sinara-hw/zapper/README.md

# Zapper
EEM with high-voltage source/PZT driver

## Design Files

Design files (schematics, PCB layouts, BOMs) can be found at [Zapper/Releases](https://github.com/sinara-hw/Zapper/releases).

## Wiki

More information can be found on the [wiki](https://github.com/sinara-hw/Zapper/wiki).
