sinara-hw/zapper/(list of files, drawings)

Other design files:
PCB/DAC_8CH.SchDoc
PCB/Filter.SchDoc
PCB/LVDS.SchDoc
PCB/OutputChannel.SchDoc
PCB/PowerSupp.SchDoc
PCB/SCHMITT_LED.SchDoc
PCB/Zapper.PrjPcb
PCB/Zapper.SchDoc
