sinara-hw/zapper/(threads)

Thread 1 (2019-02-06):

[RFC] new EEM: zapper (high-voltage source/PZT driver)

dtcallcock, 2019-02-06:
High voltage supplies are commonly required in ion trap experiments.  These are widely commercially available but typical models have many of the following drawbacks:

- Noisy output
- Radiated RFI from the box
- Expensive
- Poor stability
- Low channel density
- High power dissipation when voltage output static
- Unnecessarily high current capability (safety issue as well as being the root cause of most of the above)
- Flaky USB connection with high latency

# Use cases

### Trap electrode voltages

Zotino only provides ±10V.  This is generally fine for small high-electrode-density surface traps.  However many groups operate larger surface traps or macroscoptic traps of the 'blade' or 'wafer' variety.  These typically need much higher voltages, from a few 10s of Volts up to a few hundred Volts.  Requirements are basically the same as for Zotino but scaled to higher voltages.  The [thesis](https://www2.physics.ox.ac.uk/sites/default/files/2011-08-15/cjbthesisfinal_pdf_33239.pdf) of Chris Ballance has a good discussion of the requirements and a circuit design that could be the basis of this EEM.  This type of trap generally has less electrodes so a <32-ch solution may be acceptable.

### Slow piezos

We have several piezo-actuated mirrors on our experiment, such as the Thorlabs [Polaris K1S2P](https://www.thorlabs.com/newgrouppage9.cfm?objectgroup_ID=5035).  These need 0-150V and have a 0.35uF of capacitance.  The Thorlabs [MDT694B/MDT693B](https://www.thorlabs.com/newgrouppage9.cfm?objectgroup_id=1191) are ubiquitous in our lab but suffer many of the problems described above.  For this use case, the new [PiezoDrivePD32](https://www.piezodrive.com/product/pd32-multi-channel-piezo-driver/) may be a good commercial alternative when coupled with a Zotino.  I haven't tested one out but we have been happy with other products from PiezoDrive.

# Implementation

### DAC

16-bit resolution.

A few options:

- Use Zotino.  The card would sit next to Zotino and be connected to the IDC headers on it via a ribbon cable(s).  Lower risk, less development work, and the Artiq driver would be pretty much for free.  Frees up board real estate as no EEM connector etc. would be needed.

- Use an onboard DAC.  The 32-ch AD5372 in Zotino has 8-ch ([AD5362](http://www.analog.com/en/products/ad5362.html)) and 16-ch ([AD5360](http://www.analog.com/en/products/ad5360.html)) equivalents if that is likely to reduce risk/effort.  At 4-ch and 8-ch, more accurite, lower noise DACs are available.

### Channel Count

This will probably depend a lot on the power consumption, size, and cost of the output stage we decide on.  8 would be a reasonable starting point.

### Ranges

Traps generally require a mix of high positive voltages for endcaps (becasue our ions are positively charged) and lower bipolar voltages for other electrodes.  There seems to be 2 options for dealing with this:

- Per board range selection.  The board could be configured as either single ended or bipolar.  If different ranges are required, you just use two boards.  The cheaper the board is and the lower the number of the channels, the less of an issue this is.

- Per channel range selection.  Board has three supply rails (+V1, +V2 and -V2).  Each channel can be changed to run at 0 to +V1 or -V2 to V2 using jumpers or component selection.

### Voltages

It would be good to hear from potential users here.  As a starting point, how about:

0 to +V1 or -V2 to +V2 where V1= 200, 100, or 50V and V2 = 100, 50 or 25V

Historically some traps have used >1kV but my guess is that there isn't a sensible design that covers that and 10s of volts.

### Bandwidth

Zotino has 75kHz analog bandwidth.  This sounds like a reasonable starting point.

There should be the option to install components that drastically limit this to say, 100s of Hz.

### Stability

Zotino output stage has "Worst-case OpAmp self-heating is about 25C. At 0.2ppm/C, this is 4ppm, which is fine!"  This might be harder to achieve at high voltages but <10ppm would be nice.

### Connectors

- Individual Front Panel coax connectors - Often slightly less common connectors are used on HV supplies to prevent accidentaly connecting the wrong thing and destroying it.  I have seen SMB, SMC, LEMO OO and LEMO 0B used.

- High Density Connector - D-sub etc.

- Both - Same idea as Zotino, where the high density connector can be installed or a ribbon cable run to a panel with individual connectors on it (ie. a [BNC-IDC](https://github.com/sinara-hw/BNC_IDC/)).  We could make a version of BNC-IDC with SMB etc. instead.

hartytp, 2019-02-06:
Neat. What's the plan? Will you use a potted module? HV OpAmps? Or discrete components? Will it be something like the JQI design?

gkasprow, 2019-02-06:
Let's try to build a discrete amplifier circuit. HV power supply could be COTS component.

hartytp, 2019-02-06:
Cool, it's a fair bit of work that way, but if you get it right the performance is really good. Also, more fun :)

IIRC, the JQI design is based from a laser printer IC which provides the HV supply. Then they add a linear circuit to do post regulation. I think that's probably the best way to go.

gkasprow, 2019-02-06:
do you mean [this](http://sci-hub.tw/10.1063/1.4969059) design?

hartytp, 2019-02-06:
That's the one. I've never used it, but it seems nice. Probably worth asking @npisenti for his views on what they like/dislike about the circuit and any ideas they have for improvements.

A few channels of something like that on an EEM would be ace. Maybe PoE?

There are a few design decision you need to make like modulation sources (analog? digital? EEM?) bandwidth etc.

hartytp, 2019-02-06:
For the post regulator, might also being worth checking out the design that @cjbe posted a while ago.

IIRC there are (as always) some nice designs for this in the Hobbs book (and I remember seeing some designs for comically low noise PZT drivers in various places he lurks on the internet).

JakeBlackmore, 2019-03-18:
Hello,
I was directed here by a colleague using ARTIQ. Is there scope for a version of this design which works up to +/- 5 kV?

gkasprow, 2019-03-18:
The specification is not yet fully defined. What BW and slew rate do you need? What load capacitance? What did you use before?

gkasprow, 2019-05-31:
I have an application where a lot of channels is needed, 8 or even 16 per module, +/- 150V at least with reference to GND and ultra-low noise, a few uV pp. Bandwidth is not that critical, a few kHz does the job. Load capacitance is not critical, I will have tens of pF.
Such a driver could be based on Zotino to keep the SW compatibility to some extent.
Can we compile the final specification for my student which also includes specification above?

hartytp, 2019-05-31:
> Such a driver could be based on Zotino to keep the SW compatibility to some extent.

I'm fine with keeping the HV amp and DACs on separate boards if you prefer. However, FWIW, my feeling is that having fewer boards in the stackup is always better. It's trivial to add a multi-channel DAC + filters to your HV amb board, so not much time saved by using Zotino for this. (However, if you use a DAC in the same family as the Zotino DAC then you can reuse the same design and software, so it's just a copy-paste job).

gkasprow, 2019-05-31:
Oh, I meant modifying the Zotino design :)
I want to have a single multi-channel board that has HV, DAC, and drivers on the same PCB.
Would the Zotino DAC speed be enough for your application? Or it would be better to rather switch to Fastino type DACs?

hartytp, 2019-05-31:
> Oh, I meant modifying the Zotino design :)

Aah, glad we agree :)

> Or it would be better to rather switch to Fastino type DACs?

That would be nice as it allows things like locking cavities at a decent bandwidth. The downside is that doing that with a decent number of channels makes the digital interface more complex (misoc/artiq doesn't support QSPI right now).

gkasprow, 2019-05-31:
well, we can make the SPI interface first, then upgrade the FPGA. The same we will probably do for Fastino.

gkasprow, 2019-06-01:
What about the following spec:
- channel count: 8
-  low [cost Apex amplifiers](https://www.digikey.com/products/en/integrated-circuits-ics/linear-amplifiers-instrumentation-op-amps-buffer-amps/687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), PA341DF would be rpobably fine
- 8 channel AD5362
- at each output we can install active AC-coupled noice cancellation circuit that can be disabled by software when high speed operation is required. We can use OPTOMOS relays to diasable it.
- operating voltage could be controlled by DIP switches. Negative -50, -100, -200, positive +50, +100, +200 with limitation of 350V with HW protection against opamp damage. DAC references would need to be adjusted as well.
- COTS DC/DC converters
- what about the offset cancellation ADC?
- EEM interface. It can be always controlled by Stabilizer EEM and supplied by its PoE.
- DSUB connector + on-board IDC connector for BNC breakout.

gkasprow, 2019-06-01:
By noise cancellation circuit I meant [this](https://github.com/JQIamo/hv-piezo-driver/blob/master/Eurocard-HV-piezo-driver_Schematic_v1.2.pdf) approach

gkasprow, 2019-06-01:
Two such [DC/DC](https://recom-power.com/pdf/Innoline/Rxx-B.pdf) converters could do the job. They go down to 90V but could not find others that can be adjusted more than 90...200V

restelli, 2019-07-11:
> For everyone considering PDu150, the outputs are differential only, NOT single ended, and you cannot ground-reference one output. Thus it won't work for typical piezo actuators where the signal is ground-referenced on one lead.

Neil Pisenti and I a few years ago designed a ground-referenced low noise piezo driver for the JQI strontium lab based of the [DRV2700](http://www.ti.com/product/DRV2700). Despite the DRV2700 being quite noisy by itself we were able to suppress its ripple and obtain noise levels comparable with the best commercial controllers. Noise characterization and overall design are available in our RSI paper: https://arxiv.org/abs/1609.03607

The project is on Github: https://github.com/JQIamo/hv-piezo-driver

The main limitations of the design is that the control bandwidth is limited for large amplitude signals.

sbourdeauducq, 2019-08-07:
If we have a lot of bandwidth (1MHz or more), then this circuit can also be useful with EOMs (e.g. https://www.thorlabs.com/newgrouppage9.cfm?objectgroup_id=2729) for laser intensity stabilization.

dtcallcock, 2019-08-08:
Note that the standard drivers for these are +/- 200V, 100mA beasts.  If that's what you are after it may be incompatible with (my hope of) something that's higher channel density, lower noise, and lower power consumption than what's already out there.

sbourdeauducq, 2019-08-08:
200V*1MHz*14pF = 2.8mA. Are the standard drivers able to go much higher than 1MHz, is the 14pF specification inaccurate, or is there something else going on?

dtcallcock, 2019-08-08:
Don't forget that coax cable is some 10s of pF/ft.

Still, their driver does seem a bit over-specced.  Also somewhat overpriced at $2.6k...

jordens, 2019-08-08:
And there is a factor of 2*pi > 6 as well.

adamkolodynski, 2020-01-23:
Hello
I have a few questions about the design of this board.
1. Are onboard DAC required? Using Zotino would make it way simpler, and there is always a possibility to add e.g. fast DAC later, in another version.
2. What power supply is available, except the EEM connector?

dtcallcock, 2020-01-23:
Hi #adamkolodynski

Are you developing the spec Greg laid out [above](https://github.com/sinara-hw/zapper/issues/1#issuecomment-497932589)?

If so:

> Are onboard DAC required? Using Zotino would make it way simpler

Sure, but Zotino is quite expensive.  Having to add a pricy 32ch card to use this card would be a bit annoying.  Using AD5362 (8ch version of AD5372 32ch DAC on Zotino) should allow a lot of Zotino design/code reuse.

> there is always a possibility to add e.g. fast DAC later, in another version.

If the analog BW is <100kHz, then the AD5362 should be able to pretty much saturate that.  There could also be an IDC input connector on the board and jumpers to disconnect the DAC to allow this.

> What power supply is available, except the EEM connector?

If it has DACs on it and power consumption is reasonable then I think just EEM is fine and in line with what's done elsewhere.

gkasprow, 2020-01-23:
About the power supply selection, look [here](https://github.com/sinara-hw/Stabilizer_Piezo_Driver/issues/4)

JakubKajzer, 2020-02-01:
Does anybody need a noise cancellation circuit in this module?

adamkolodynski, 2020-02-21:
After reading the thread about power supply I see some major issues.
Can we use ADHV4702 with -12V and +110V supply, or keep PA341DF?
Is +110V enough range in this use?
ADHV4702 has 20 mA output current, what load we have to drive if we still target 100 kHz?

sbourdeauducq, 2020-02-21:
PA341 is "No longer supported for design in" and no longer supplied by DigiKey.
FWIW I've also had a bad experience with an Apex part that was expensive and not performing so well; I would trust ADI more or even a design with discrete BJTs (not so hard to do IME and you can exceed the performance of commercial ICs - but BJTs with the right characteristics can be subject to sourcing problems as well).

gkasprow, 2020-02-22:
I'd give an option to adjust the positive HV value.
The negative would be -5V, the positive could be 105 or 205V. The IC requires 2V supply margin.
The power supplies need to have LC filter and LDOs at its outputs.

gkasprow, 2020-02-22:
Before you publish the entire schematic, please open separate issues with proposed parts of schematics like decoupling, DAC, supply, etc It will make the feedback faster.

adamkolodynski, 2020-03-31:
I started 2 new issues. First about DAC, and second about the power supply, and will probably add another about the output stage.

gkasprow, 2020-07-16:
can you please commit the current version of schematics?

adamkolodynski, 2020-07-20:
I have a few questions about connectors.
One I assume will be IDC to connect with this [IDC-BNC adapter](https://github.com/sinara-hw/BNC_IDC/wiki). I don't know the purpose of SCSI power pins(+-13V) here, should I left them floating?
The second will be standard D-SUB connector, and since we don't use differential output just reference to GND and low currents can we use 15 pins D-SUB with 8 signal pins and 7 GND or simply 25 pins D-SUB with 8/8 pins configuration and rest unconnected.
[Zapper.pdf](https://github.com/sinara-hw/zapper/files/4950283/Zapper.pdf)

gkasprow, 2020-07-20:
I wouldn't use the same connectors as Zotino. Sooner or later someone will mix the two and cause damage.
Just use the D-SUB connector. High-density D-SUBs may not like the 200V range. Just use standard 15pin D-sub. Maybe there are some standard cables available that could be used as they are? If so, it would be nice to follow their pinout...

adamkolodynski, 2020-08-07:
I found standard 15 pin D-sub cable and it belongs to GAMEPORT cable(obsolete standard for joystick). Is it worth following this pinout(picture below): signals to analog and digital pins, gnd to gnd and +5V?
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
About breakout to BNC from DA-15, is it required to create an adapter similar to existing [link](https://github.com/sinara-hw/BNC_IDC/wiki) ?

gkasprow, 2020-08-12:
VGA  have some lines shielded, some not, so it is not good idea.
The Gameports cables were attached to joysticks, I'm not sure if one can buy them.
I was thinking about DB15 serial cables like this [one ](https://www.amazon.com/Your-Cable-Store-10-DB15/dp/B002HYJS7I)

adamkolodynski, 2020-08-14:
I meant exactly cable like this, just I found it described as gameport to gameport, anyway they are hard to find, so I will leave pinout like it is now.
I made some minor changes(resistor tolerance, track width, etc.) to the first release. I already asked @gkasprow as my supervisor for a more complex check, but I would appreciate any feedback.

Thread 3 (2020-02-28):

Zapper - 8 channel DAC and EEM

adamkolodynski, 2020-02-28:
### DAC voltage range
I think the best output range would be 0 to+10 V, [DAC](https://www.analog.com/media/en/technical-documentation/data-sheets/AD5362_5363.pdf) has also configurable offset registers, but I don't know how convenient are their usage. The voltage range is defined by 4xVref, but we have to be in +-1.4 V from the power supply. I see two options:
-	Power supply -5 V/+12 V, Vref=2,5 V, but we need to use offset registers.
-	Power supply +-12 V, Vref =5 V, but we losing half of the span.

### DAC additional functions
Translating signal from EEM and DAC design are very similar to Zotino, but [AD5362](https://www.analog.com/media/en/technical-documentation/data-sheets/AD5362_5363.pdf) has more additional functions that AD5372, so I need to know which can be useful.
1. Packet Error Check Output - now connected to EEM connector, but if any more important use of this I/O appears probably will leave it.
2. Monitor - output could be connected to a gold pin(or another connector) and used for testing and monitoring.
3. Temperature sensor - might be useful later.
4. Programmable GPIO - will find some application later.

### Current schematic files

[LVDS schematic](https://github.com/sinara-hw/zapper/files/4266615/LVDS.pdf)
[DAC_8CH.pdf](https://github.com/sinara-hw/zapper/files/4266616/DAC_8CH.pdf)

gkasprow, 2020-04-21:
@jordens do you think we could need the PEC output?
Yes, add a standard test pad.
we don't expect the DAC to overheat.

please connect the VREF pins.

jordens, 2020-04-21:
not critical

adamkolodynski, 2020-04-27:
Added test pads and VREF: [DAC_8CHv2.pdf](https://github.com/sinara-hw/zapper/files/4539184/DAC_8CHv2.pdf)
How about the offset voltage calibration similar to this [Automated Calibration](https://www.analog.com/media/en/technical-documentation/application-notes/AN-1582.pdf)

gkasprow, 2020-05-01:
I think the offset will be dominated by the output stage offset anyway. No real reason to calibrate the DAC only.

adamkolodynski, 2020-07-20:
I found that AD5362BCPZ run of out stock in most distributors(except Chinese sites which is hard to verify), so I changed it to AD5362BSTZ which is also hard to buy but still available.

gkasprow, 2020-07-20:
Use two footprints and assembly options as we do in Zotino

adamkolodynski, 2020-07-20:
In Zotino DAC packages have the same pin number and pin description and here one has 52 pins and the second has 56 pins. Their description and placements are not fitting in many cases. I don't think it is possible here.

gkasprow, 2020-07-20:
U can try to place them side-by-side. We don't have high-speed signals here.

Thread 4 (2020-03-30):

Zapper - power supply

adamkolodynski, 2020-03-30:
### [Zapper](https://github.com/sinara-hw/zapper/issues/1) power supply
In previous threads about zapper, it was mentioned that the most fitting output voltage range would be 0-200 V. ADHV4702-1 accepts 220 V supply(maximum rating mention 225 V), so we need at least -5 V/205 V(unless 190/195 would work too).

The lowest possible quiescent current per channel is 0,6 mA(with 100k Ohm resistor in ADHV 4702-1) but reduces dynamic performance, so I think 50k Ohm will be better solution and reduction to 1 mA is enough.
I found some DC/DC converter which fit required >200V or eventually 200V, but I need to know how much current per channel we need on output, and if we need a switchable operating range. Below there are some converters which I find useful.

1. [SF_F_Series](https://github.com/sinara-hw/zapper/files/4403075/SF_F_Series.pdf) or [SF_FS_Series](https://github.com/sinara-hw/zapper/files/4403076/SF_FS_Series.pdf) 10 W converters with regulation 0 to 200 V, or 0 to 300 V, but quite expensive(150$ F series, 180$ FS). The output is proportional to the input but heavily depends on the load.
2. [VG10 Series ](https://github.com/sinara-hw/zapper/files/4403168/VG10.Series.Full.Specification.pdf) -10 W, 250 V output voltage, but only 90$
3. [Rxx-B](https://github.com/sinara-hw/zapper/files/4403202/Rxx-B-334986.pdf) - 5 W, regulated from 92 V to 200 V, around 40$
4. American Power Desing has few models which could fit, but they are no available in Mouser/Digikey only from one distributor in Europe.

JakubKajzer, 2020-04-02:
If the output current of ADHV4702-1 is too low, we can use [PA441](https://www.apexanalog.com/resources/products/pa441u-pa443u.pdf) (next generation of PA341), it has 60mA continuous output current and 120mA in peak and 350V max voltage supply.

For a negative voltage supply (if we keep -5V), I think we can use COTS modules like this:

1.  [NMJ Series](https://www.farnell.com/datasheets/2625591.pdf) from Murata - 100mA, 60% efficiency
2. [TES 2N Series](https://www.tracopower.com/products/tes2n.pdf) from Traco Power - 200mA, 73% efficiency
3. [R1D series](https://pl.mouser.com/datasheet/2/468/R1S_R1D-1709880.pdf) from Recom - 100mA, >72% efficiency

They are symmetrical voltage converters, so maybe somewhere positive 5V will be useful.
For low output current, the ripple and noise can be significant, so it must be well filtrated.

adamkolodynski, 2020-04-04:
Output current is mostly limited by EEM connector, and according to the [wiki](https://github.com/sinara-hw/meta/wiki/EEM) board can draw 2A@12V, so 120mA@200V is impossible even with a single channel.

About negative voltage supply, I think about symmetrical voltage converter 5V, where -5 V will be connected to LDO(-4,5V), and +5 to 3,3V regulator to supply LVDS translation(around 400mA). However this requires converter with a higher power, and LDO 5->3,3 mean losing significant power.

JakubKajzer, 2020-04-04:
ADHV4702-1 have 20mA max output current. If we keep 8 channels as is mentioned in the thread about zapper it can draw 160mA@200V at one moment. So probably we need another power supply input or lower channel density.

About the 3V3 supply, I think that instead of LDO, we can take TPS62175DQC like in Zotino, but the input range of this IC is 4.75V to 28 V so it's quite near 5V and it can be less efficient than LDO.

gkasprow, 2020-04-21:
The output is purely capacitive. We will consume such current only during voltage change. So don't worry about power suply current

gkasprow, 2020-04-21:
Copy the 3V3 converter design from other designs. For -5V you can use small 1W power converter

adamkolodynski, 2020-05-14:
I added 3V3, 11,5 V and -4,5 V. How about using a cascade of [R12-100B](https://recom-power.com/pdf/Innoline/Rxx-B.pdf) to provide HV? [PowerSupp.pdf](https://github.com/sinara-hw/zapper/files/4628496/PowerSupp.pdf)
With two converters in series we have enough output power(5W is not enough) but doubled ripple(max. 200 mVpp). With higher voltage, we can add a voltage regulator and an LC filter.
Only one with such wide input voltage is [LR8](https://www.mouser.com/datasheet/2/268/20005399A-909415.pdf) but it has too low maximum current.
Maybe we can use floating LDO for example [LT3085](https://www.analog.com/media/en/technical-documentation/data-sheets/3085fb.pdf) or [LT3080](https://www.analog.com/media/en/technical-documentation/data-sheets/3080fc.pdf) or even LM317.

JakubKajzer, 2020-05-20:
How about using one R12-150B which can go up to 200V and have 5W output power? 1.6W goes to supply quiescent current. We can add a bulk capacitor (max is 40uF for R12-150B) to have additional charge and we still have 3.4W to charge or discharge piezoelectric.

dtcallcock, 2020-05-20:
Will you add an option to switch the HV rail to say +110V?  100V is sufficient for many piezo applications and this would allow power dissipation to be reduced and eliminate the risk of accidentally overdriving the piezo.

adamkolodynski, 2020-05-20:
If you say it's necessary, R12-150B can be regulated +200 V to +92 V with a single switch, so two ranges 200V and 110V are possible.
Using an electrolytic bulk capacitor is the option if we want to use a single 5 W converter, but we don't have an extra voltage range for LDO so the ripple will be more significant.

dtcallcock, 2020-05-20:
> If you say it's necessary, R12-150B can be regulated +200 V to +92 V with a single switch, so two ranges 200V and 110V are possible.

This is also true with cascaded R12-100B as they have a 50-135V range.

> if we want to use a single 5 W converter, but we don't have an extra voltage range for LDO so the ripple will be more significant.

How much of this ripple is likely to end up on the output given the PSRR of the opamp?  If a reg is needed then I think a 180V max output for example isn't the end of the world.

adamkolodynski, 2020-05-20:
> This is also true with cascaded R12-100B as they have a 50-135V range.

In datasheet Vout range of R-12-100B is limited/recommended to 190V-260V.
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

I asked RECOM technical support about this, and they answered:

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

> How much of this ripple is likely to end up on the output given the PSRR of the opamp? If a reg is needed then I think a 180V max output for example isn't the end of the world.

Max. ripple is 100mVpp on 20MHz bandwidth, with 200kHz switching frequency. ADHV4702-1 have around 30 dB +PSSR for 200kHz. Usually, regulators don't have high ripple rejection in higher frequencies so it's not necessary to add one.

dtcallcock, 2020-05-21:
> In datasheet Vout range of R-12-100B is limited/recommended to 190V-260V.

Sorry, I missed that section.

> Usually, regulators don't have high ripple rejection in higher frequencies so it's not necessary to add one

So perhaps just use the R12-150B with passive filtering to augment the opamp PSRR to reduce the ripple below the noise floor?

adamkolodynski, 2020-06-05:
I added R12-150B with a panel switch to change from +200 V to +110 V. LC filter should give around -38 dB on 200 kHz to reduce output ripple. I used a film capacitor with low ESR so I added 2 Ohms resistor to avoid peak at the resonance frequency.

[PowerSupp2.pdf](https://github.com/sinara-hw/zapper/files/4735527/PowerSupp2.pdf)

dtcallcock, 2020-06-05:
- I think there is a missing resistor between VREF and VADJ.

- Should there be a pi filter on the input of the switcher to help prevent conducted EMI going back into the rest of the crate?  For example, here's the input filter from Fastino:

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

> a panel switch to change from +200 V to +110 V

Is hot switching undesirable?  If so, it may be better to put it down on the PCB to discourage that (or accidental switching in general).  I don't think it's something people will need regular access to.

adamkolodynski, 2020-06-10:
>I think there is a missing resistor between VREF and VADJ.

VREF has a 1k resistor already unless it means something else(datasheet below). Maybe I should show it somehow on the schematic.
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

> Should there be a pi filter on the input of the switcher to help prevent conducted EMI going back into the rest of the crate? For example, here's the input filter from Fastino:

Yes, should I add a separate filter to the HV converter, and second for rest converters or single pi filter is enough?

>Is hot switching undesirable? If so, it may be better to put it down on the PCB to discourage that (or accidental switching in general). I don't think it's something people will need regular access to.

I will change the switch to PCB mounted. Even if hot switching shouldn't be an issue, changing range shouldn't be used very frequently.

Thread 5 (2020-04-16):

Zapper - Opamp

JakubKajzer, 2020-04-16:
# [Zapper](https://github.com/sinara-hw/zapper/issues/1) - Opamp

## Input
### Low pass filter
At the input, I've decided to make a two-stage low-pass filter to decrease noise bandwidth at ADHV4702-1 input. Filter has 100kHz 3dB bandwidth, I've chosen that frequency because it's close to max frequency of DAC.
### Clamping diodes
Clamping diodes protect the device from overheating when operating continuously at or near full power bandwidth but reduce dynamic performance (significantly decrease slew rate). I'm not sure if we need them, so I left a placeholder for them.
## Output
### Gain
Gain is set to 20V/V to cover 0-200V from 0-10V DAC.
### Stability
For stability when driving a capacitive load, there is a serial output resistor, parallel resistor to load and a small capacitor between COMP and OUT pin to reduce output stage peaking associated with capacitive loads.
##### Series resistor
47ohm resistor is a value from simulations, for this value, the opamp is stable from 10pF to 100uF capacitance load. But it decrease bandwidth. For 22ohm resistor, for capacitance loads from 10nF to 1uF, gain can increase by 4dB according to simulations. Maybe with COMP capacitor, it will work fine for 22ohm.
##### Parallel resistor
According to the ADHV4702-1 datasheet, the amplifier is more stable if it has a parallel resistive load to load with capacitance. The datasheet doesn't specify the value of this resistor. In a typical application, they suggested 10k at ±105V output, so for 0-200V at output I think 33k will be okay.
##### COMP capacitor
ADHV4702-1 have external compensation pin. Placing about 5-6pF capacitor can significantly increases the stability while driving capacitive loads. So I choose 5.6pF capacitor.
## Features
### Short-circuit protection
ADHV4702-1 has a shutdown pin (SD) and a temperature sensor pin (TMP). Connecting them and placing 200k resistor to ground will provide short-circuit protection through the thermal shutdown feature.
### Quiescent current
Quiescent current can be set within a range from 0.6mA to 3.3mA. Low current reduces dynamic performance and increase noise. Reduction to 1mA with a 50k resistor is a balance between low current and low noise.

[Opamp.pdf](https://github.com/sinara-hw/zapper/files/4486564/Opamp.pdf)

gkasprow, 2020-04-21:
Please add some signalization of the overtemp condition. I'd add OR function of all TEMP signals and connect to the front panel LED

JakubKajzer, 2020-05-10:
I added a Schmitt trigger to show the actual state of the opamp (on/off).
CD4078BMT (8-input) OR gate will be perfect for this application.

[Opamp.pdf](https://github.com/sinara-hw/zapper/files/4605438/Opamp.pdf)

dtcallcock, 2020-05-20:
>0.6mA to 3.3mA. Low current reduces dynamic performance and increase noise. Reduction to 1mA with a 50k resistor is a balance between low current and low noise.

A DIP switch to select might be nice here.  Being able to half the board's quiescent dissipation from 1.6W to 0.8W (+ decrease in converter losses) is a nice feature if you don't need the dynamic performance.

> a parallel resistive load to load with capacitance. ... so for 0-200V at output I think 33k will be okay.

This resistor dissipates 1.2W at 200V output.  That seems excessive.

JakubKajzer, 2020-06-18:
> A DIP switch to select might be nice

The DIP switch has been added. I was thinking about adding two SPST DIP switch to choose 3.3mA, 1mA, or 0.6mA quiescent current but finally, I left it as is.

> This resistor dissipates 1.2W at 200V output. That seems excessive.

I overlooked this. According to the opamp datasheet, it slightly increases stability for unity gain configuration, so it doesn't change much there. I left this resistor as a placeholder.

[Opamp.pdf](https://github.com/sinara-hw/zapper/files/4799377/Opamp.pdf)

adamkolodynski, 2020-07-02:
Hello
I checked the existing schematic and made some changes :
1. You have used double op-amp AD8676 one to lowpass filter and second to the Schmitt trigger. I'm pretty sure u can't use both op-amps with different voltage supply, and you connected two different voltages to V+ pin(nr 8) and V- pin. I changed filter opamp to single-channel AD8675. It has additional null pins but I think when most offset come anyway from ADHV4702-1 there is no point in using them.
[OutputChannel.pdf](https://github.com/sinara-hw/zapper/files/4866971/OutputChannel.pdf)

2. I moved Schmitt trigger to another schematic where I used 4-channel AD8544 which has less quiescent current and saves place(AD8676/75 has not been specified below 10V of supply anyway). I don't think we need 3$ opamp to Schmitt trigger so I used a cheaper one. I changed one resistor in the voltage divider to have more accurate thresholds(1,6V and 0,8V). In the end, I added a LED board indicator that was used before in a few designs (Zotino, Fastino maybe some more).
[SCHMITT_LED.pdf](https://github.com/sinara-hw/zapper/files/4866965/SCHMITT_LED.pdf)

3. In the main thread, it was mentioned zapper could have an AC-coupled noise cancellation circuit. I think we can use zero offset lowpass filter, a similar approach to [LINK](https://www.edn.com/zero-offset-active-lowpass-filter-part-1/) and [LINK2](https://ir.library.louisville.edu/cgi/viewcontent.cgi?article=2077&context=etd) It doesn't affect the DC but reduces bandwidth a lot. Resistor R13 should double the R11 value to achieve the proper Q factor. And the values of the capacitors we can change depends on what resonant frequency we want.
The only thing is how to properly switch it off. One way is to use MOSFET photocoupler which at least 200V Voff, the problem is that they have usually around 20 Ohms ON-state resistance, which is not acceptable, but I found Toshiba relays with lower resistance(max. 2 Ohms). [TLP3825](https://toshiba.semicon-storage.com/eu/semiconductor/product/optoelectronics/photorelay-mosfet-output/detail.TLP3825.html) [TLP3549](https://toshiba.semicon-storage.com/ap-en/semiconductor/product/optoelectronics/photorelay-mosfet-output/detail.TLP3549.html) [TLP3558A](https://toshiba.semicon-storage.com/ap-en/semiconductor/product/optoelectronics/photorelay-mosfet-output/detail.TLP3558A.html) but it will still degrade a bit filter characteristics.
The second option is simply SPST toggle switch but I don't know how much insulation resistance and dielectric strength should it have to work fine with 200VDC in a long time(cold switching).

JakubKajzer, 2020-07-13:
1.
> I'm pretty sure u can't use both op-amps with different voltage supply

Sorry, my mistake, thanks for finding this.
> I changed filter opamp to single-channel AD8675.

If you decided to use another opamp for Schmitt trigger, why we can keep double opamp, it will occupy less area on PCB, or use even quadruple opamp.

3.
There is a [issue](https://github.com/sinara-hw/zapper/issues/6) about noise cancellation. Zero offset lowpass filter sounds good, but if we keep R13 as a doubled value of R11, it's hard to achieve tens of hertz passband (if we want to reduce 1/f noise) without having tens of microfarads. If we raise R13 value, then will be a problem with the Q factor.

Thread 6 (2020-05-20):

Zapper - filter stage

JakubKajzer, 2020-05-20:
# Filter stage
I have designed a switchable low pass filter (3db BW is 5Hz) to reduce noise and bandwidth. I have used two in series capacitors and resistors so they can withstand 200V.  I have used a double photoMOS relay and DIP switch to turn on/off filtration.

[Filter.pdf](https://github.com/sinara-hw/zapper/files/4653900/Filter.pdf)

dtcallcock, 2020-05-20:
Don't you need [balancing resistors](https://www.illinoiscapacitor.com/pdf/Papers/voltage_balancing_resistors.pdf) to add capacitor voltage ratings like that?

You can get [450V rated 1210 C0G caps](https://www.digikey.com/product-detail/en/tdk-corporation/C3225C0G2W223J230AA/445-15463-1-ND/4278636) and [400V rated 0805 resistors](http://www.koaspeer.com/products/resistors/high-voltage/hv73/).  A bit non-standard but still <$1 components.

JakubKajzer, 2020-05-20:
I've checked some Vishay resistors and they were 150V rated, so I decided to place two in series, but you're right, I found [250V rated 0603 capacitors](https://www.mouser.com/ProductDetail/TDK/CGA3E3C0G2E102J080AE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) and [350V rated 0603 resistors](https://www.mouser.com/ProductDetail/ROHM-Semiconductor/KTR03EZPF3303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) so I'm going to change the schematics.

dtcallcock, 2020-05-20:
The AQW210EHA has a typical Ron of 18Ohms.  This should be considered when selecting the series output resistor for the opamp.

How about using DIP switches directly to avoid this and remove a point of failure?  You could also then use DPDT to disconnect the filter from the output completely.  At these frequencies, parasitics shouldn't cause problems.  They [can't hot switch 200V](http://www.grayhill.com/assets/1/7/DIP_Series_76_and_78_DPDT.pdf) but I think it's fine to require the board to be off when switching.

JakubKajzer, 2020-06-18:
> How about using DIP switches directly to avoid this and remove a point of failure?

I think we don't need to turn on/off filter often, so no possibilities of hot switching shouldn't be a problem.
I've changed also the filter components.

[Filter.pdf](https://github.com/sinara-hw/zapper/files/4799871/Filter.pdf)

gkasprow, 2020-07-16:
@JakubKajzer please commint all the Altium source files.

adamkolodynski, 2020-07-20:
This way of switching off resolve a major problem with zero offset filter I proposed in OPAMP issue. Bypassing the whole filter allows us to place large resistance in series with op-amp output. I used dual ADA4807-1 which requires only 1mA/channel and two 0805 68nF capacitors. In a result filter with the same -3dB frequency has a better slope in lower frequencies(to 1 kHz) and it doesn't kill op-amp output current(time of setting the voltage on capacitive load).
[FilterZeroOffset.pdf](https://github.com/sinara-hw/zapper/files/4946164/FilterZeroOffset.pdf)

Is CM choke is necessary? This one is rated only 80 V and it's hard to find 200V rated. [This](https://www.digikey.com/product-detail/en/murata-electronics/PLT10HH101150PNL/490-12821-1-ND/4422452) has 300VDC but it's very expensive 10$/channel unless we use chokes for AC power lines e.g [Schaffner RN](https://pl.mouser.com/datasheet/2/355/RN_Series-978565.pdf) which  are cheaper but bigger.

gkasprow, 2020-07-20:
CMCS make sense when we have fully symmetrical load. Piezos are referenced to GND so CMC will do more harm than help.

Thread 8 (2020-08-12):

schematic review

gkasprow, 2020-08-12:
- [ ] make sure the schemtics designtors do not overlap
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
- [ ] the module must fit within 4HP slot. the switches are too high. use smaller ones, DIP switches would do the job.
- [ ] the C51 is too high. why film capacitor was used?
- [ ] R4 won't work for 200V due to 0603 package. Use 1210 package instead or two 0805 resistors in series
- [ ] what is R9 for?
- [ ] use DIP switch as SW1
- [ ] use only CERN components. If they do not exist, let me know
- [ ] do we need AD8544 for LEDs? use LM324 or something low cost
- [ ] add 0R resistors for debugging: reference output,
- [ ] when changing he HV, adjust the amplifier gain accordingly. Add gain setting DIP switch to the DAC
- [ ] P200V0 is misleading since this value depends on SW0 setting
- [ ] this is low noise design. Are you sure the SMPS noise is sufficiently filtered by LC filter and HV amplifier PSRR for SMPS operating frequency? What is HV amplifier PSRR at such high frequency? One may need to add HV LDO.

jordens, 2020-08-14:
You can get rid of the A side switches at the input to the noise eaters.

gkasprow, 2020-09-29:
- [ ] the EEM connector is placed in random way. Please ensure CPCIS adapter compatibility

Thread 9 (2020-09-06):

v1.0 testing

gkasprow, 2020-09-06:
@dtcallcock @hartytp @dhslichter
The first prototype is assembled.
What tests do you want us to perform?

dtcallcock, 2020-09-22:
How about testing the following, both with no load and a 1uF load to simulate a piezo:

- Small signal bandwidth
- Full power bandwidth
- Slew Rate
- RMS output noise with with filter
- RMS output noise without filter

Now, with 3 voltage output settings and 3 opamp bias current settings, that would be 90 distinct measurements so it might be worth picking a bias current and voltage for exhaustive testing and just do a few spot checks on other combos.

dtcallcock, 2020-09-22:
The spec sheets that piezo drive make are quite nice and could be a bit of a template: https://www.piezodrive.com/drivers/pd32-32-channel-piezo-driver/

gkasprow, 2020-09-22:
when testing, do not use ceramic capacitors because they have very strong C=f(V)

Thread 11 (2025-02-11):

DIOT version

gkasprow, 2025-02-11:
- [ ] Add DIOT connectors; use DIOT template, copy schematics and layout
- [ ] Increase the N4V5 to at least -7V; for the moment, the negative part of DAC cannot be used; we need +/-5V at the output; change IC9 to MEA1D0509SC; modify IC11 feedback divider; modify the net name
- [ ] Modify IC2 divider to shift the voltage by 5V; input range -5..+5V must be translated to 0..10V
- [ ] Modify IC1x divider to have 20x gain; R4+R5 must be 19x R3
- [ ] Get rid of SW0; set 200V range
- [ ] Get rid of mechanical switches; replace them with opto-mos switches like in HV_DAC8 design
