sinara-hw/zapper/(commit log)

2020-08-06 v1.0rc1
    First pre-release
    [DAC_8CH.SchDoc, Filter.SchDoc, LVDS.SchDoc, OutputChannel.SchDoc, PCB_Project.PrjPcb, PowerSupp.SchDoc, SCHMITT_LED.SchDoc, Zapper.PrjPcb]
2020-09-02 First prototype
    [DAC_8CH.SchDoc, Filter.SchDoc, LVDS.SchDoc, OutputChannel.SchDoc, PowerSupp.SchDoc, SCHMITT_LED.SchDoc, Zapper.PrjPcb, Zapper.SchDoc]
